dpannem21/hydro_auto/hardware_schematic .pdf

## Arduino Mega2560

## DS18B20

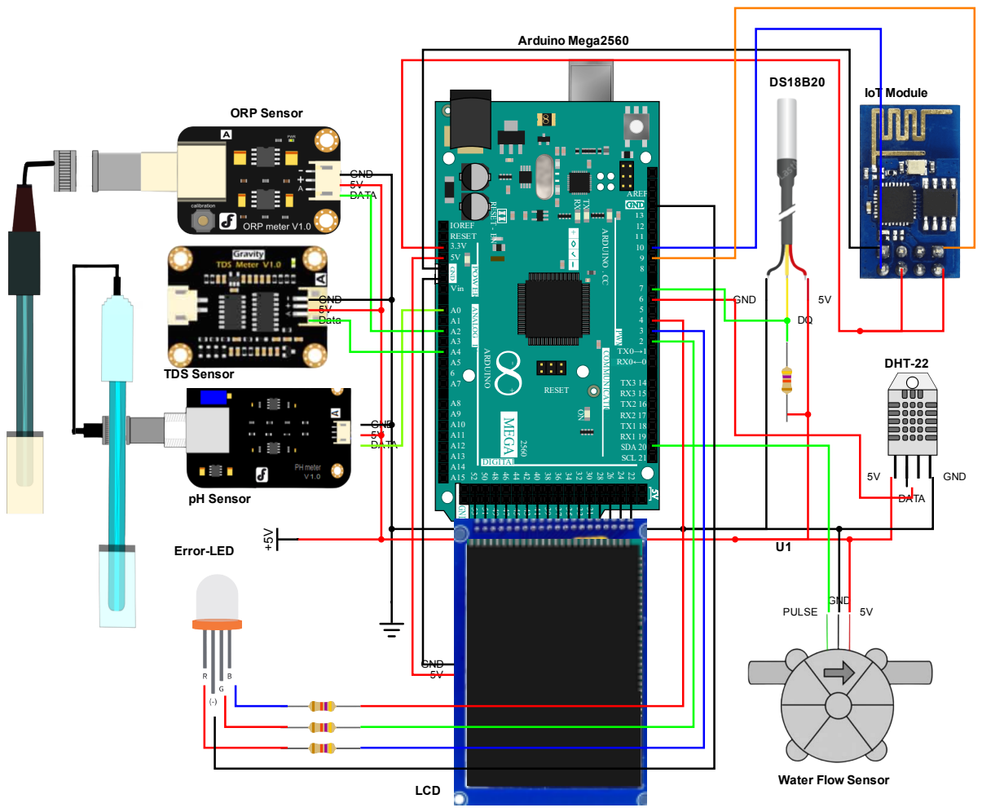
[picture p2: page 1]
COM; MUNICATION; ARDUINO . CC; ARDUINO DIGITAL; TX3 14 RX3 15 TX2 16 RX2 17 TX1 18 RX1 19 SDA 20 SCL 21; RESET; IOREF RESET 3.3V 5V; Vin; AREF GND; GND; RESET - EN; DATA; DHT-22; pH Sensor; ORP Sensor; PULSE; IoT Module; GND 5V; LCD; Data; TDS Sensor; Error-LED

POWER ANALOG IN

Water Flow Sensor
